Dolu1990/pmod_usb_host_x4/README.md

Important !

- The PMOD connector is on the bottom side of the PCB in kicad, but should be solder on the top.
- The 5V pin of the board need to be connected to your main board 5V. (the design was made during covid, when all the buckboost went out of stock XD)
