Dolu1990/pmod_usb_host_x4/pmods.pdf

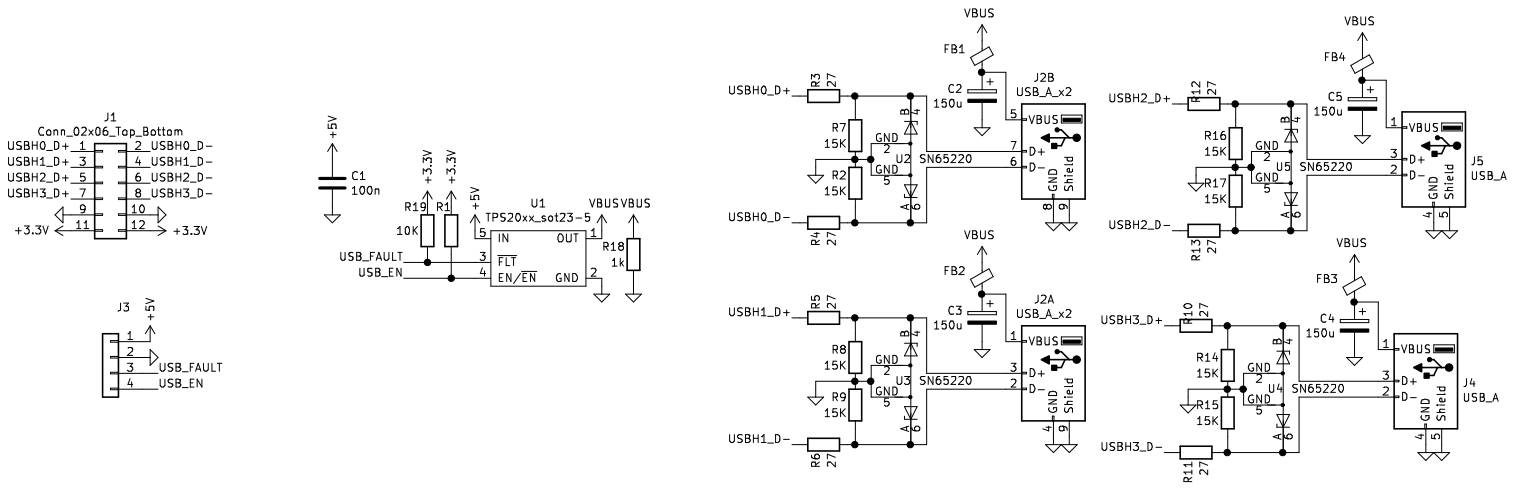
[picture p1: page 1]
