Dolu1990/pmod_usb_host_x4/pmods.kicad_pcb

## KiCad design pmods.kicad_pcb (2021-05-07)

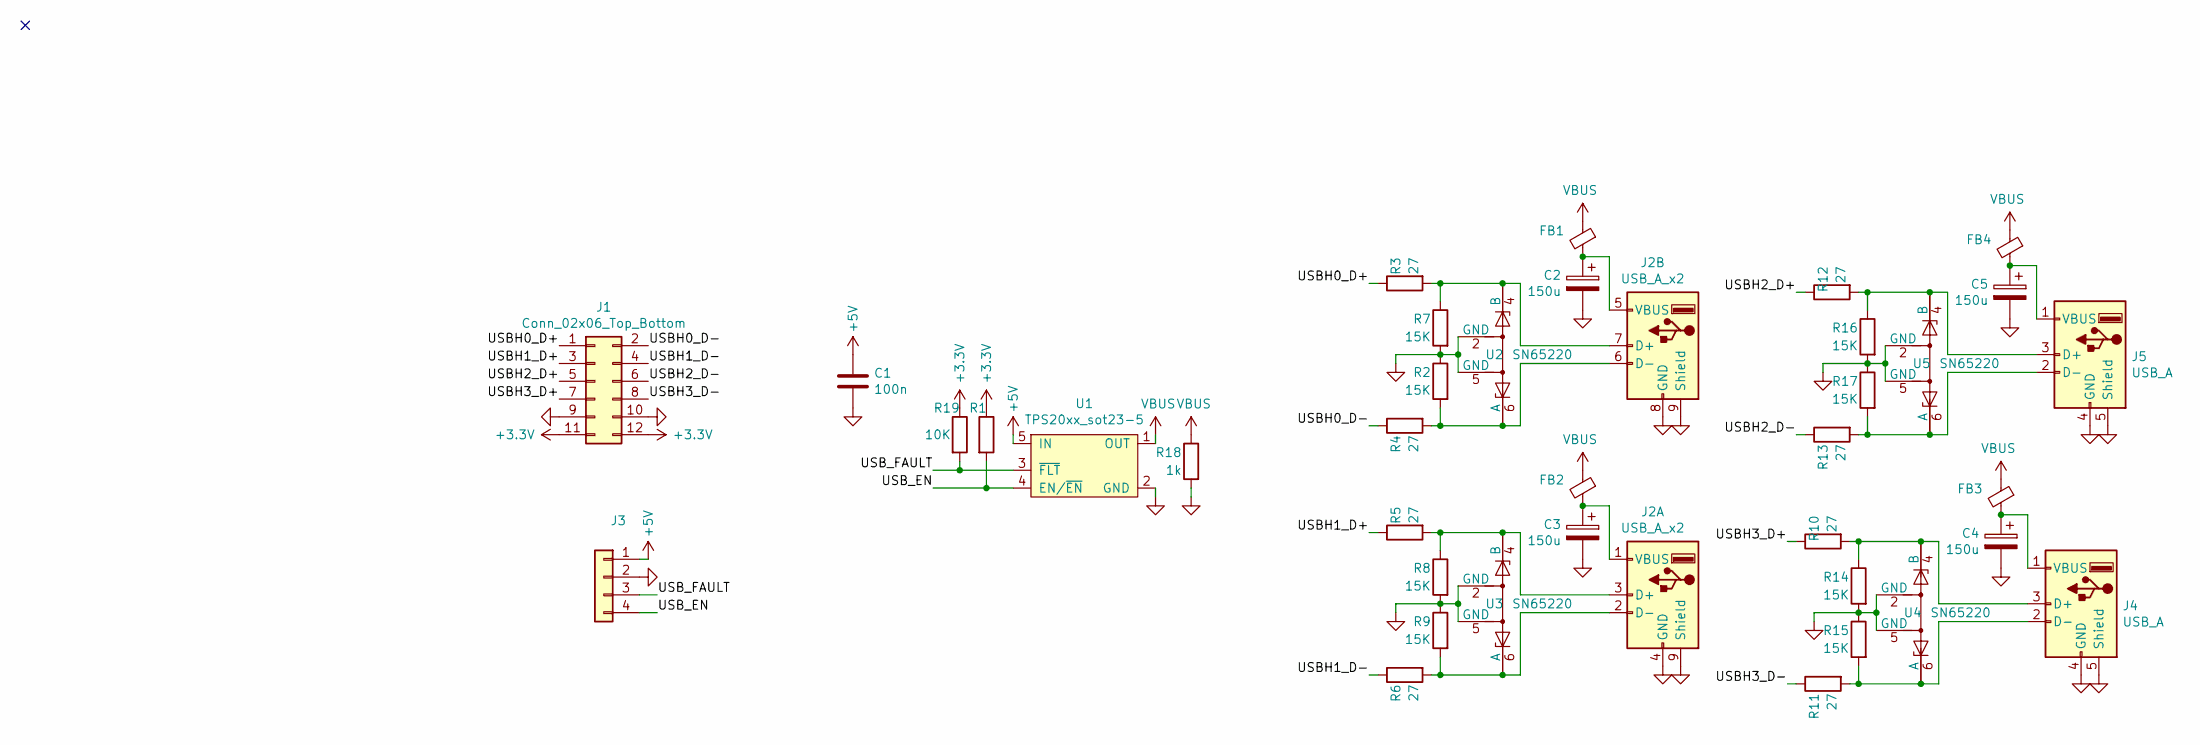
[picture p2: schematic pmods.sch]

Parts:
C1: 100n; C_0603_1608Metric_Pad1.08x0.95mm_HandSolder
C2, C3, C4, C5: 150u; C_1206_3216Metric_Pad1.33x1.80mm_HandSolder
FB1, FB2, FB3, FB4: Ferrite_Bead_Small; L_0805_2012Metric_Pad1.05x1.20mm_HandSolder
J1: Conn_02x06_Top_Bottom; PinHeader_2x06_P2.54mm_Horizontal
J2: USB_A_x2; USB_A_Wuerth_61400826021_Horizontal_Stacked
J3: Conn_01x04; PinHeader_1x04_P2.54mm_Vertical
J4, J5: USB_A; USB_A_Molex_105057_Vertical
R1, R19: 10K; R_0603_1608Metric
R2, R7, R8, R9, R14, R15, R16, R17: 15K; R_0603_1608Metric
R3, R4, R5, R6, R10, R11, R12, R13: 27; R_0603_1608Metric
R18: 1k; R_0603_1608Metric
U1: TPS20xx_sot23-5; SOT-23-5
U2, U3, U4, U5: SN65220; SOT-23-6

Connections:
+3V3: J1.11, J1.12, R1.1, R19.1
+5V: C1.1, J3.1, U1.5 (IN)
/USBH0_D+: J1.1, R3.1
/USBH0_D-: J1.2, R4.1
/USBH1_D+: J1.3, R5.1
/USBH1_D-: J1.4, R6.1
/USBH2_D+: J1.5, R12.1
/USBH2_D-: J1.6, R13.1
/USBH3_D+: J1.7, R10.1
/USBH3_D-: J1.8, R11.1
/USB_EN: J3.4, R1.2, U1.4 (EN/~EN~)
/USB_FAULT: J3.3, R19.2, U1.3 (~FLT~)
GND: C1.2, C2.2, C3.2, C4.2, C5.2, J1.9, J1.10, J2.4 (GND), J2.8 (GND), J2.9 (Shield), J3.2, J4.4 (GND), J4.5 (Shield), J5.4 (GND), J5.5 (Shield), R2.1, R7.2, R8.2, R9.1, R14.2, R15.1, R16.2, R17.1, R18.2, U1.2 (GND), U2.2 (GND), U2.5 (GND), U3.2 (GND), U3.5 (GND), U4.2 (GND), U4.5 (GND), U5.2 (GND), U5.5 (GND)
unnamed: C2.1, FB1.2, J2.5 (VBUS)
unnamed: C3.1, FB2.2, J2.1 (VBUS)
unnamed: C4.1, FB3.2, J4.1 (VBUS)
unnamed: C5.1, FB4.2, J5.1 (VBUS)
unnamed: J2.2 (D-), R6.2, R9.2, U3.6 (A)
unnamed: J2.3 (D+), R5.2, R8.1, U3.4 (B)
unnamed: J2.6 (D-), R2.2, R4.2, U2.6 (A)
unnamed: J2.7 (D+), R3.2, R7.1, U2.4 (B)
unnamed: J4.2 (D-), R11.2, R15.2, U4.6 (A)
unnamed: J4.3 (D+), R10.2, R14.1, U4.4 (B)
unnamed: J5.2 (D-), R13.2, R17.2, U5.6 (A)
unnamed: J5.3 (D+), R12.2, R16.1, U5.4 (B)
VBUS: FB1.1, FB2.1, FB3.1, FB4.1, R18.1, U1.1 (OUT)

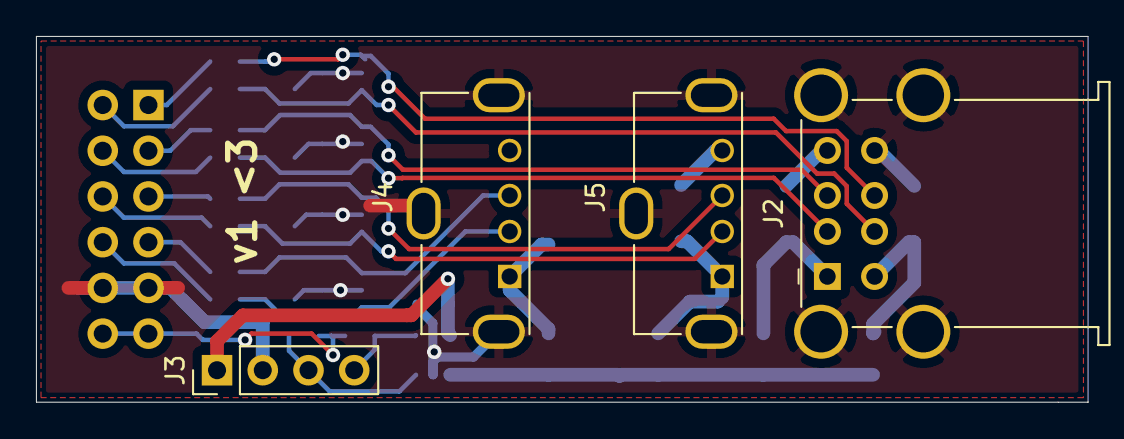
[picture p3: board pmods.kicad_pcb from above]

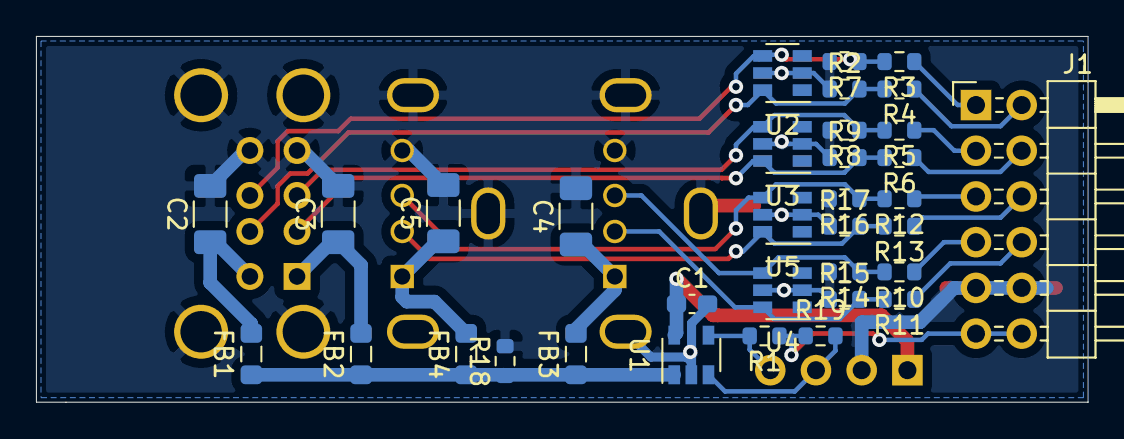
[picture p4: board pmods.kicad_pcb from below]

Board: 2 copper layers, 58.4 x 20.3 mm, 38 parts (34 on the bottom side), 26 nets.
