Dolu1990/pmod_usb_host_x4/(threads)

Thread 1 (2022-02-06):

BOM & other infos

atroger, 2022-02-06:
Hi,

Do you (still) have the BOM for the board?
Could you make it available?

Regards.
(Great work btw!)

Dolu1990, 2022-02-07:
Hi,

There it is, note that the quantities are all over the place ^^

[bom.xls](https://github.com/Dolu1990/pmod_usb_host_x4/files/8014516/bom.xls)

Also, for the 5V you need to connect it via a cable to the board.

Regards
Charles

atroger, 2022-02-07:
Thank you Charles!

atroger, 2022-02-09:
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

atroger, 2022-02-09:
Hi Charles,

I'm a bit confused about one thing: Have you used 47uF or 150uF capacitors for C2 to C5?
(I guess 150uF, according to the schematic, but I just want to be sure before ordering :) )

Dolu1990, 2022-02-09:
hmm, i don't have anything to mesure what is actualy mounted, but i would say go for the 47 uf 10V.

As 150uF x4 is realy quite a lot.

Closed 2023-10-16.
